andreac94/Enviromental_Sensor/README.md

# Enviromental_Sensor
This repository contains the project of Electroic for Embedded systems.
The projet has been developed using **Cadence** tools, in particular *Allegro PCB design*.
For further details, please read "Report.pdf".

There is also a short explanatory [video](http://bit.ly/2F9zfn5).
