andreac94/Enviromental_Sensor/(list of files, drawings)

Other design files:
datahss_project/DATAHSS.DSN
datahss_project/DATAHSS.opj
